km190112/Tanapika/tanaPika_利用者用Ver1.1.xlsm

Sheet: 開発者用テスト
テストコマンド実行

Sheet: WS00設定
設定項目 | 値 | 備考
COMポート番号 | COM4 | 送信機器のCOMポート番号を指定する。例:COM3 ボーレート:115200bps ビット長:8、パリティビット:None、ストップビット:1
AccessDB保存先 | G:\マイドライブ\Arduino_RaspberryPi\開発\08_棚ピカリ\棚検索システム\TanaPikari.accdb | AccessDBファイルのPathを入力(例：\\.............accesdb)
LED点灯色 | R | R'＝赤、'G'＝緑、'B'=青、'W'=白
LED明るさ | 20 | 輝度設定、最小0~最大255、設定範囲：10~50

Sheet: WS01物品検索
棚ピカり
 | 棚番検索 | 物品管理番号

Sheet: 棚登録
登録
文字列 | 文字列 | 文字列 | 文字列 | 文字列 | 整数 | 日付
ロケーションナンバ | 物品管理番号 | メーカ | 品名 | 型式 | 数量 | 有効期限

Sheet: 取出し
取出し
物品番号
