km190112/Tanapika/受信機の接続図.pdf

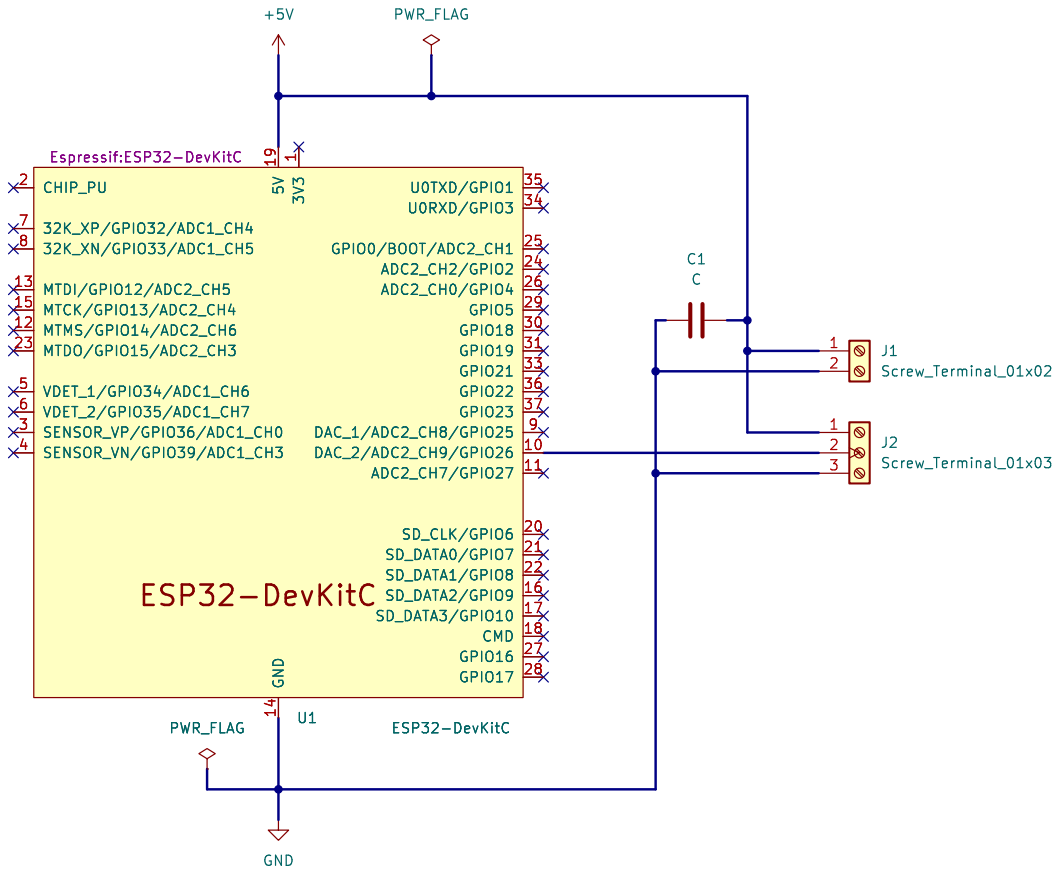
[picture p1: page 1]
